rajdeepsaha2003/ProstheticHand1/Candy/graphics/board/back.png

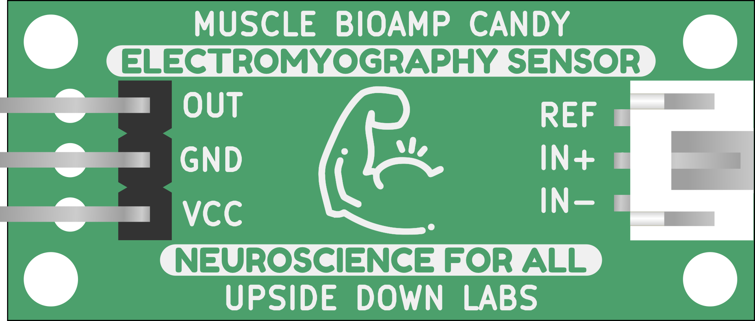
Candy/graphics/board/back.png
