rajdeepsaha2003/ProstheticHand1/Candy/graphics/board/dimensions.png

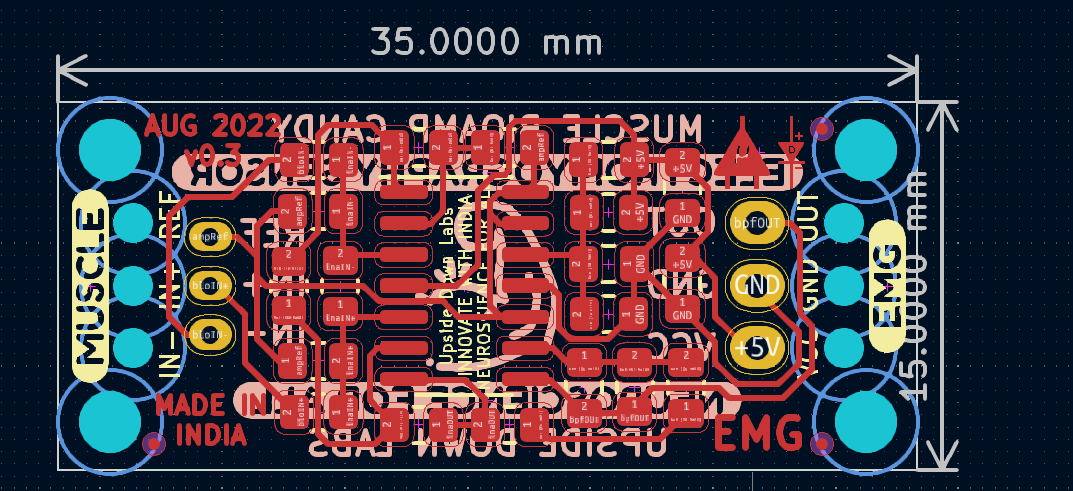
Candy/graphics/board/dimensions.png
