rajdeepsaha2003/ProstheticHand1/Candy/graphics/board/front.png

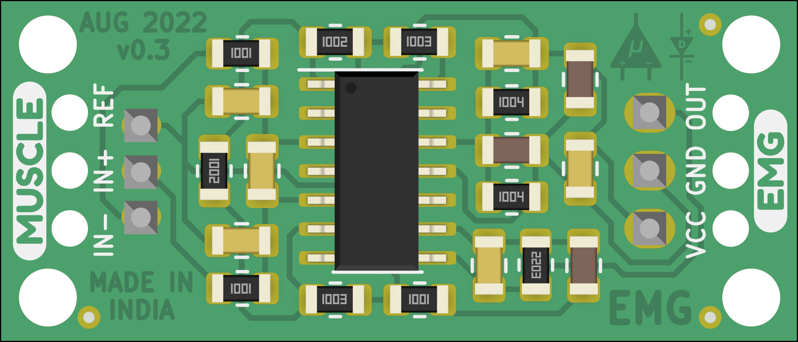
Candy/graphics/board/front.png
