rajdeepsaha2003/ProstheticHand1/Candy/graphics/board/PCBback.png

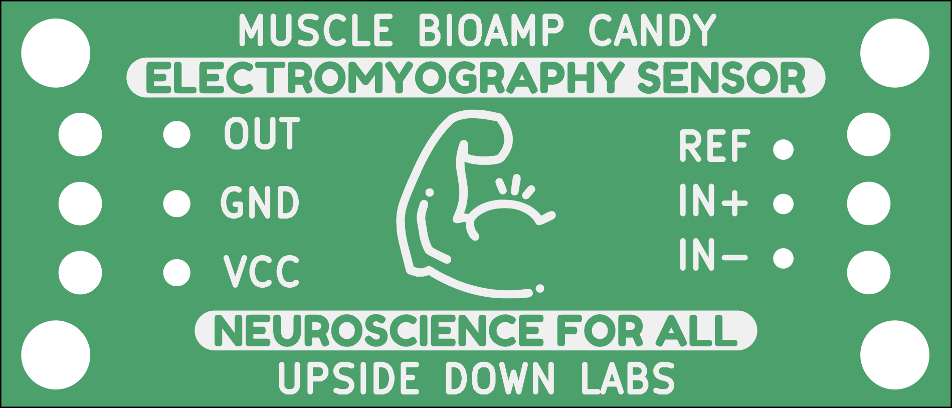
Candy/graphics/board/PCBback.png
