rajdeepsaha2003/ProstheticHand1/Candy/graphics/board/PCBfront.png

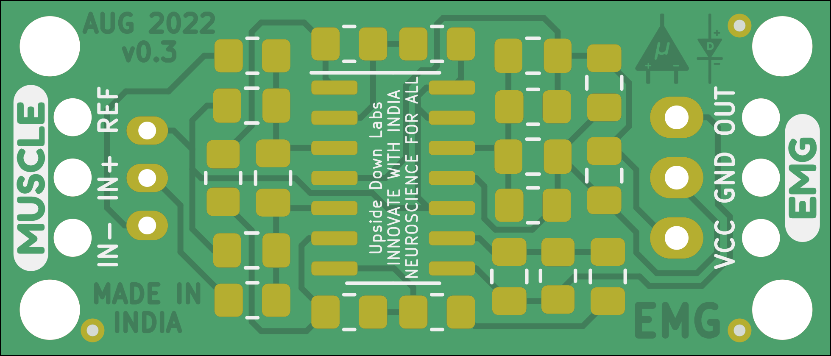
Candy/graphics/board/PCBfront.png
