rajdeepsaha2003/ProstheticHand1/Candy/graphics/ElectrodePlacementExample.png

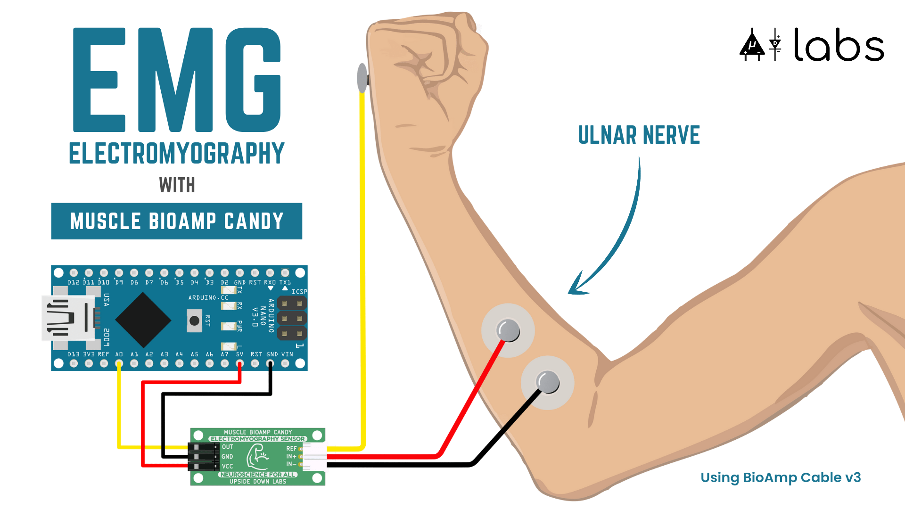
Candy/graphics/ElectrodePlacementExample.png
