rajdeepsaha2003/ProstheticHand1/media/image1.jpg

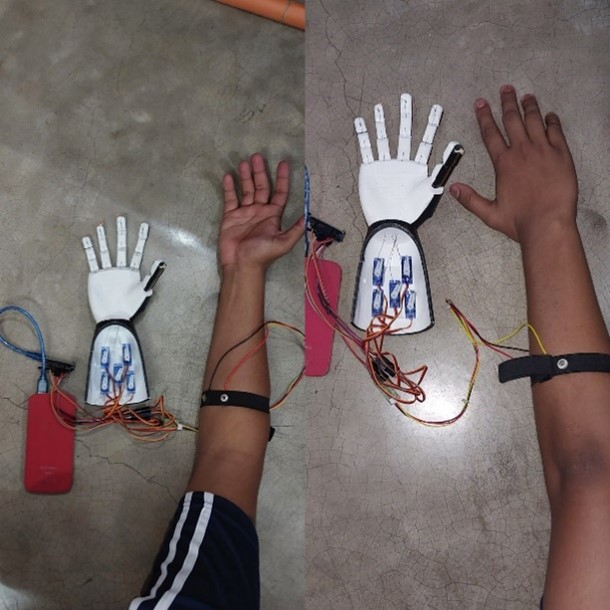
media/image1.jpg
