rajdeepsaha2003/ProstheticHand1/media/image14.jpg

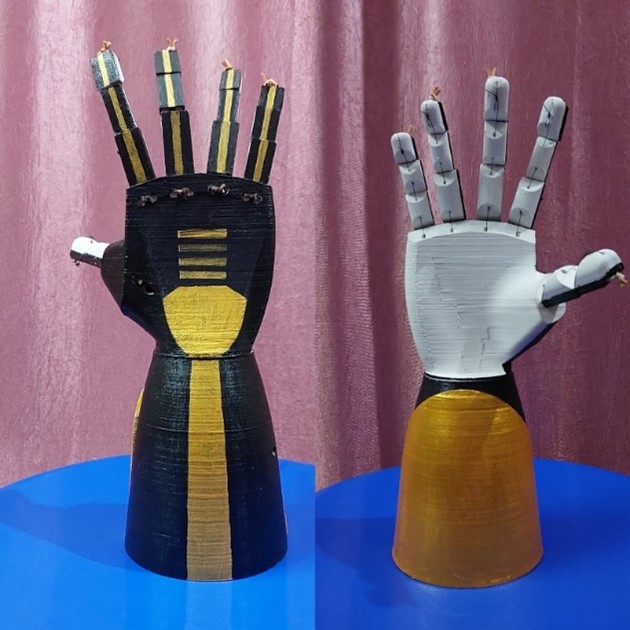
media/image14.jpg
