rajdeepsaha2003/ProstheticHand1/media/image19.png

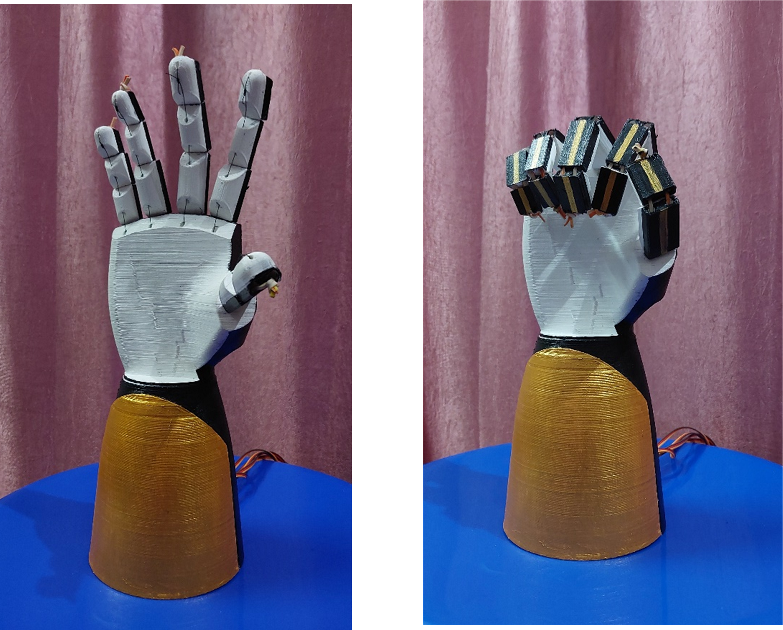
media/image19.png
