rajdeepsaha2003/ProstheticHand1/media/image21.jpg

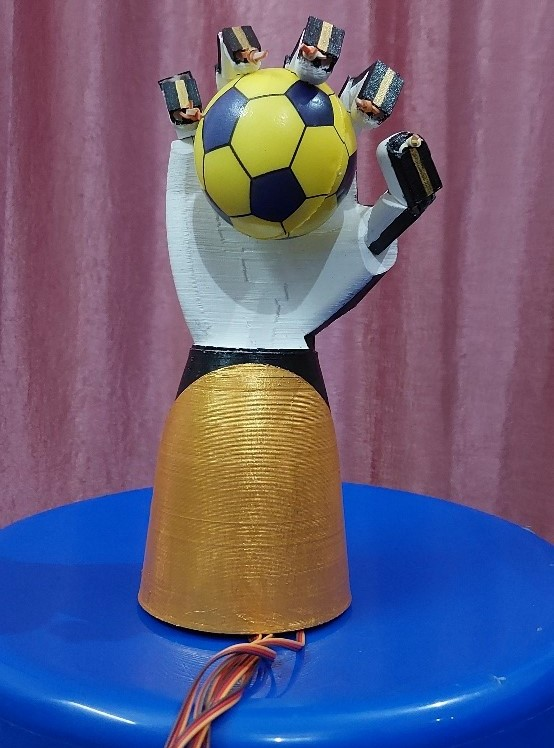
media/image21.jpg
