rajdeepsaha2003/ProstheticHand1/media/image22.jpg

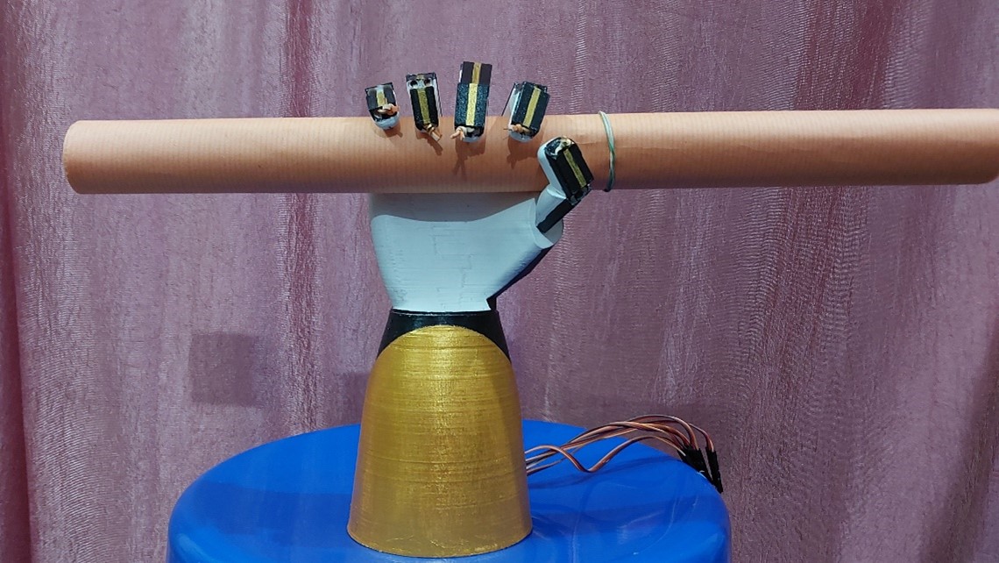
media/image22.jpg
