rajdeepsaha2003/ProstheticHand1/media/Screenshot 2024-03-30 111446.png

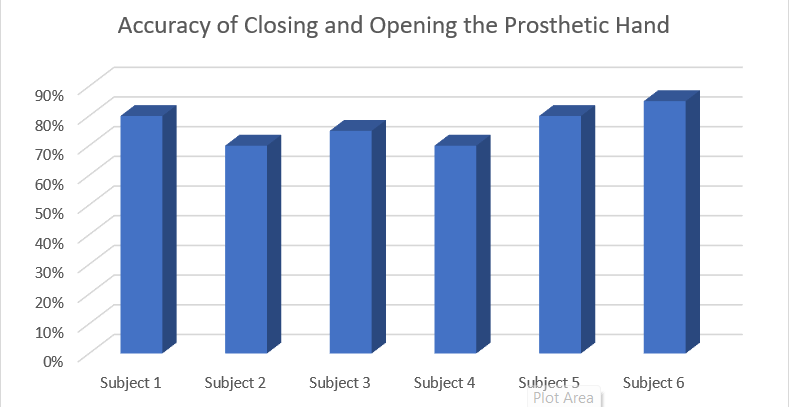
media/Screenshot 2024-03-30 111446.png
