rajdeepsaha2003/ProstheticHand1/Prosthetic_hand/3D Files Robo Hand/Screenshot 2024-03-03 145712.png

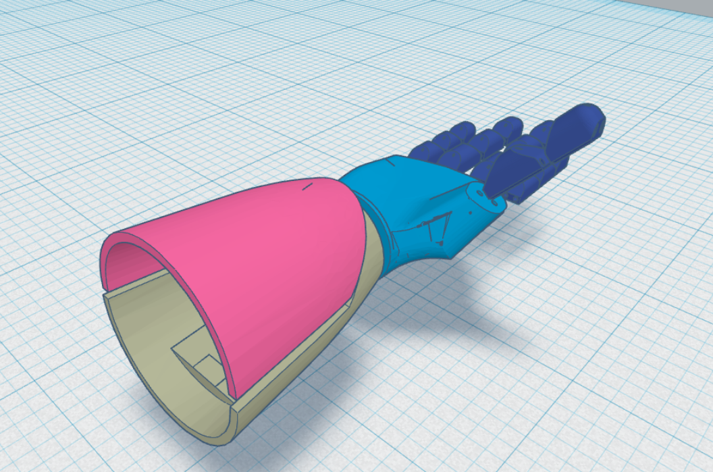
Prosthetic_hand/3D Files Robo Hand/Screenshot 2024-03-03 145712.png
