rajdeepsaha2003/ProstheticHand1/Prosthetic_hand/3D-Claw/Servo gripper v8.png

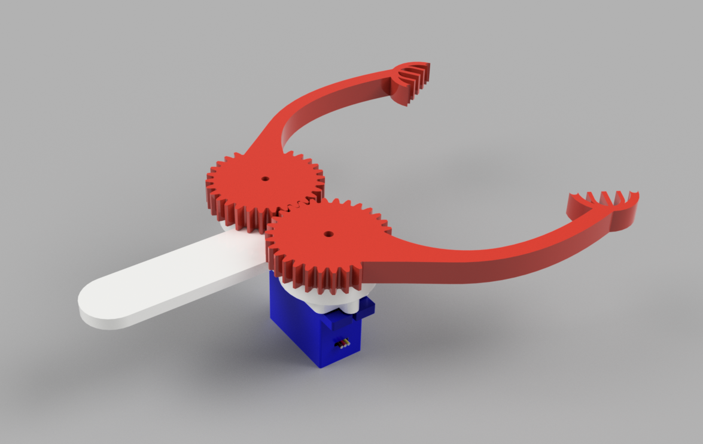
Prosthetic_hand/3D-Claw/Servo gripper v8.png
