rajdeepsaha2003/ProstheticHand1/data.xlsx

Sheet: Data In
Data In (From USB Serial Device (COM8))
Data coming from the current data source will appear below as it is received.
Current Data
TIME | CH1 | CH2 | CH3 | CH4 | CH5 | CH6 | CH7 | CH8 | CH9 | CH10
10:19:45 | -74 | 60 | 69
Historical Data
TIME | CH1 | CH2 | CH3 | CH4 | CH5 | CH6 | CH7 | CH8 | CH9 | CH10
10:19:45 | -89 | 60 | 101
10:19:45 | 83 | 60 | 8
10:19:45 | 42 | 60 | 65
10:19:45 | -4 | 60 | 101
10:19:45 | -9 | 60 | 66
10:19:45 | -59 | 60 | 86
10:19:45 | -86 | 60 | 51
10:19:45 | 31 | 60 | 2
10:19:45 | 81 | 60 | 14
10:19:45 | -18 | 60 | 22
10:19:45 | -25 | 60 | 1
10:19:45 | -75 | 60 | 0
10:19:45 | -74 | 60 | 69
10:19:45 | -99 | 60 | 7
10:19:45 | -108 | 60 | 101

Sheet: Data Out
Data Out (To Device)
Data entered into the channels below will be sent to the currently connected device as a comma-delimited string.
CH1 | CH2 | CH3 | CH4 | CH5 | CH6 | CH7 | CH8 | CH9 | CH10

Sheet: Settings
Workbook Settings
Settings below will affect how data is read into the current workbook from data sources. Clear a field's contents to revert to its default setting.
Data interval (ms) | 150 | 150
Data rows | 15 | 15
Data channels | 10 | 10
Data orientation | Newest last | Newest last
WARNING: Changing settings may result in the loss of content and/or custom formatting in the Data In and Data Out worksheets. Always save before changing values.

Sheet: Manifest
USB Serial Device |  |  |  |  |  |  |  |  | {"Channels":[{"Description":null,"Id":null,"IsGhost":false,"Name":null,"Status":"Active","SubChannels":[{"Description":null,"Id":"CH1","IsGhost":false,"Name":"CH1","Status":"Active","SubChannels":[],"UnitOfMeasure":null},{"Description":null,"Id":"CH2","IsGhost":false,"Name":"CH2","Status":"Active","SubChannels":[],"UnitOfMeasure":null},{"Description":null,"Id":"CH3","IsGhost":false,"Name":"CH3","Status":"Active","SubChannels":[],"UnitOfMeasure":null},{"Description":null,"Id":"CH4","IsGhost":false,"Name":"CH4","Status":"Active","SubChannels":[],"UnitOfMeasure":null},{"Description":null,"Id":"CH5","IsGhost":false,"Name":"CH5","Status":"Active","SubChannels":[],"UnitOfMeasure":null},{"Description":null,"Id":"CH6","IsGhost":false,"Name":"CH6","Status":"Active","SubChannels":[],"UnitOfMeasure":null},{"Description":null,"Id":"CH7","IsGhost":false,"Name":"CH7","Status":"Active","SubChannels":[],"UnitOfMeasure":null},{"Description":null,"Id":"CH8","IsGhost":false,"Name":"CH8","Status":"Active","SubChannels":[],"UnitOfMeasure":null},{"Description":null,"Id":"CH9","IsGhost":false,"Name":"CH9","Status":"Active","SubChannels":[],"UnitOfMeasure":null},{"Description":null,"Id":"CH10","IsGhost":false,"Name":"CH10","Status":"Active","SubChannels":[],"UnitOfMeasure":null}],"UnitOfMeasure":null}],"Commands":[],"DataInterval":150,"Id":"AA923046-192F-4F57-BC0B-B5F319ADB549","IsGenerated":true,"Name":"USB Serial Device","Version":null,"BaudRate":115200}
This manifest was generated for the connected device. You can edit the device name and channel data here and the Data In worksheet will be updated.
 | Channels
 |  |  |  |  |  |  | Data Source Id
 |  | Id | Name | Description | Unit of Measure | Active | AA923046-192F-4F57-BC0B-B5F319ADB549 | 1
 |  | CH1 | CH1 |  |  | ü | Data Interval (ms)
 |  | CH2 | CH2 |  |  | ü | 150
 |  | CH3 | CH3 |  |  | ü | Baud Rate
 |  | CH4 | CH4 |  |  | ü | 115200
 |  | CH5 | CH5 |  |  | ü
 |  | CH6 | CH6 |  |  | ü
 |  | CH7 | CH7 |  |  | ü
 |  | CH8 | CH8 |  |  | ü
 |  | CH9 | CH9 |  |  | ü
 |  | CH10 | CH10 |  |  | ü
