rajdeepsaha2003/ProstheticHand1/Prosthetic_hand/3D Files Robo Hand/Arm_Cover.stl

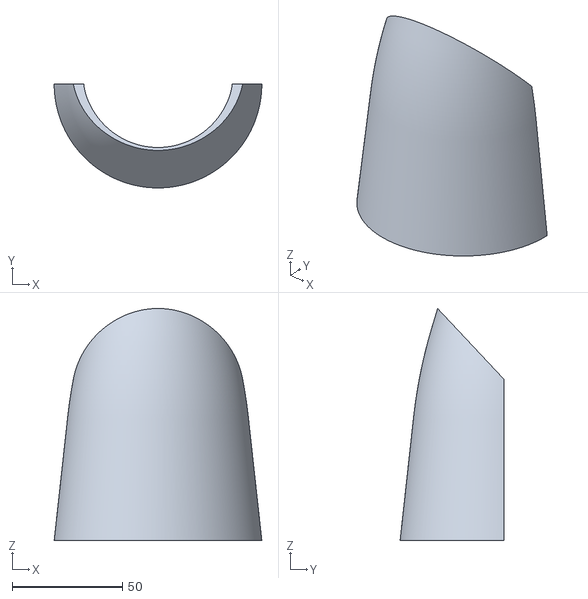
[picture p32: CAD file, 2024-03-30]
Prosthetic_hand/3D Files Robo Hand/Arm_Cover.stl
94.0 x 47.0 x 105.0
