rajdeepsaha2003/ProstheticHand1/Prosthetic_hand/3D-Claw/Base.stl

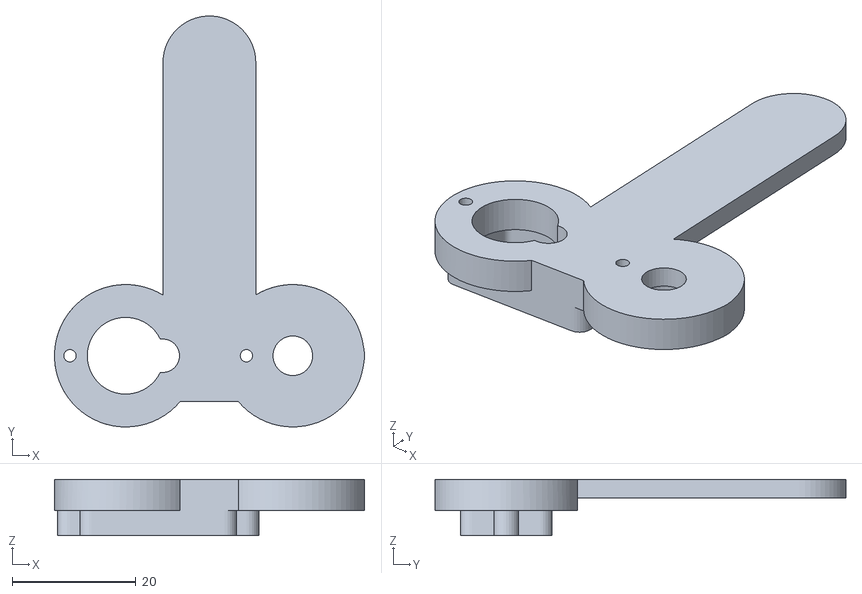
[picture p33: CAD file, 2024-03-30]
Prosthetic_hand/3D-Claw/Base.stl
50.1 x 66.4 x 9.10
