rajdeepsaha2003/ProstheticHand1/Prosthetic_hand/3D Files Robo Hand/Finger_Thumb.stl

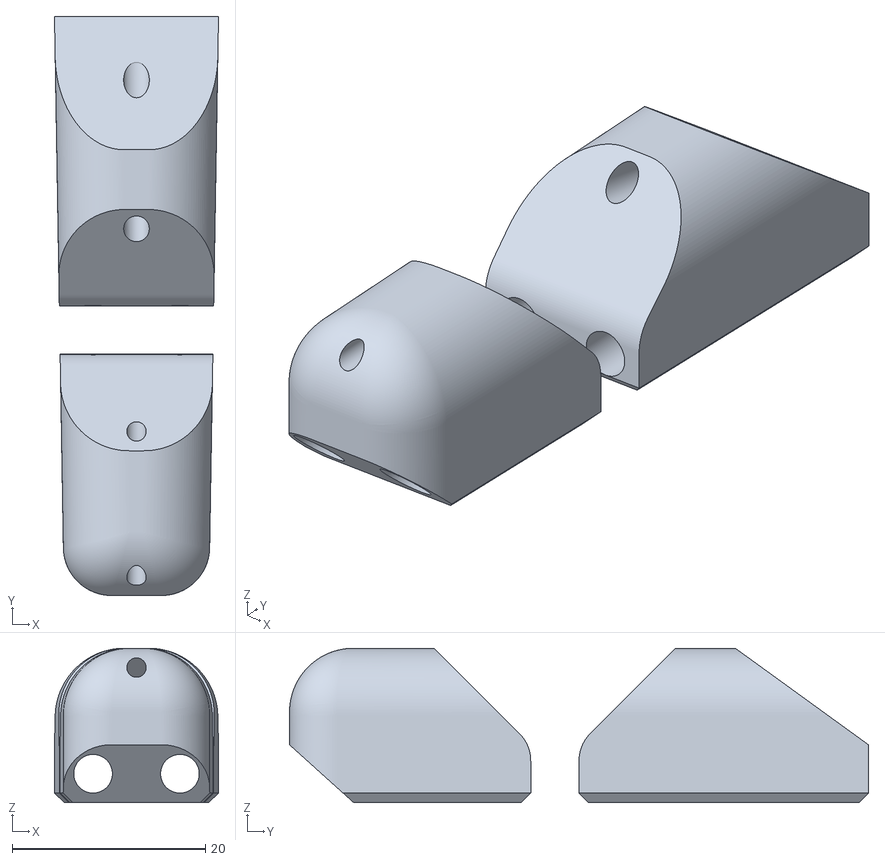
[picture p34: CAD file, 2024-03-30]
Prosthetic_hand/3D Files Robo Hand/Finger_Thumb.stl
17.0 x 60.0 x 16.0
