rajdeepsaha2003/ProstheticHand1/Prosthetic_hand/3D-Claw/arm 1.stl

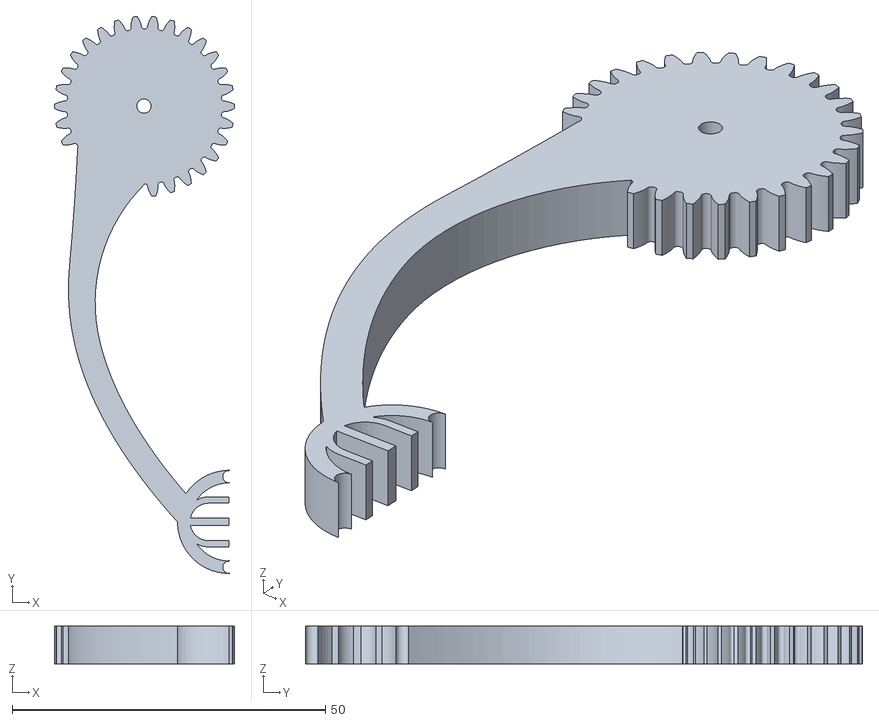
[picture p35: CAD file, 2024-03-30]
Prosthetic_hand/3D-Claw/arm 1.stl
28.8 x 88.9 x 6.00
