rajdeepsaha2003/ProstheticHand1/Prosthetic_hand/3D Files Robo Hand/Finger_Middle.stl

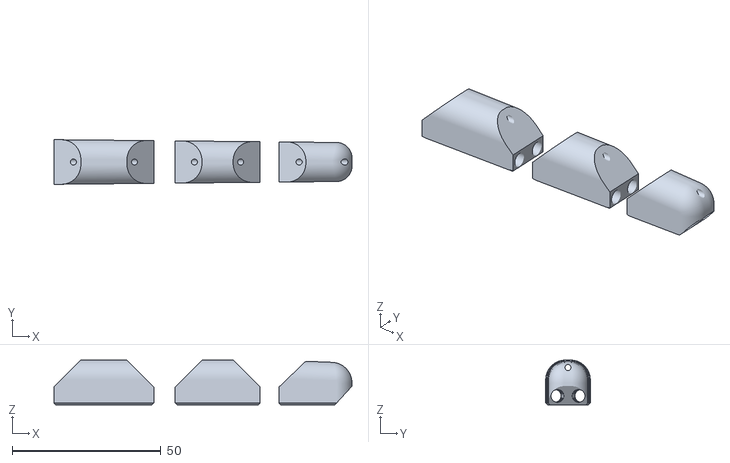
[picture p36: CAD file, 2024-03-30]
Prosthetic_hand/3D Files Robo Hand/Finger_Middle.stl
100.0 x 15.0 x 15.0
