rajdeepsaha2003/ProstheticHand1/Prosthetic_hand/3D-Claw/arm 2.stl

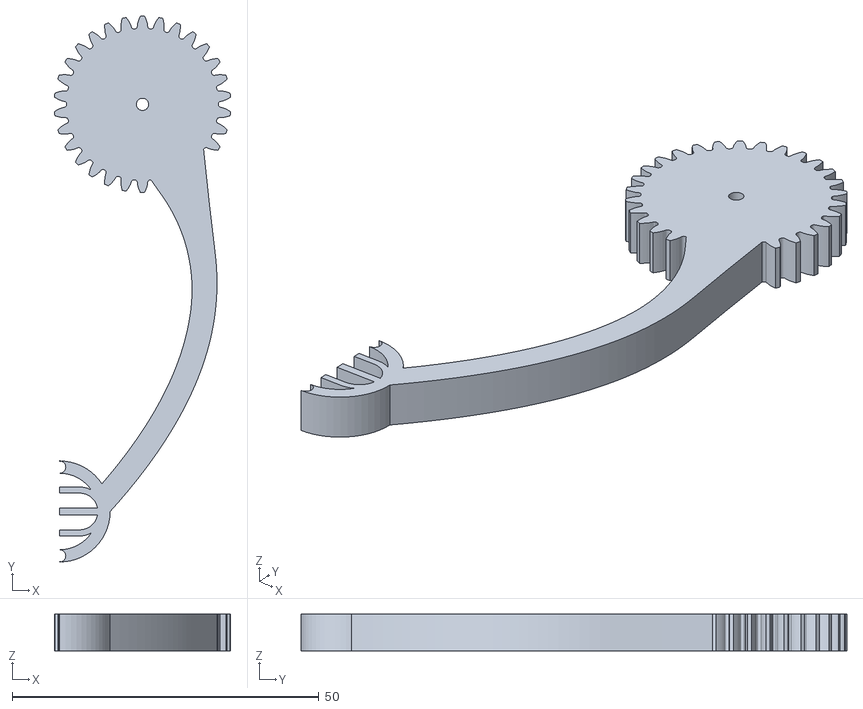
[picture p37: CAD file, 2024-03-30]
Prosthetic_hand/3D-Claw/arm 2.stl
28.7 x 89.0 x 6.00
