rajdeepsaha2003/ProstheticHand1/Prosthetic_hand/3D Files Robo Hand/Finger_Pinky.stl

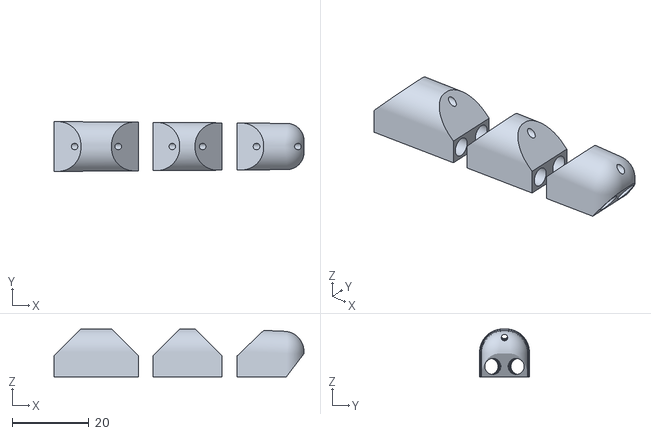
[picture p38: CAD file, 2024-03-30]
Prosthetic_hand/3D Files Robo Hand/Finger_Pinky.stl
65.2 x 13.0 x 12.5
