rajdeepsaha2003/ProstheticHand1/Prosthetic_hand/3D-Claw/gear connector.stl

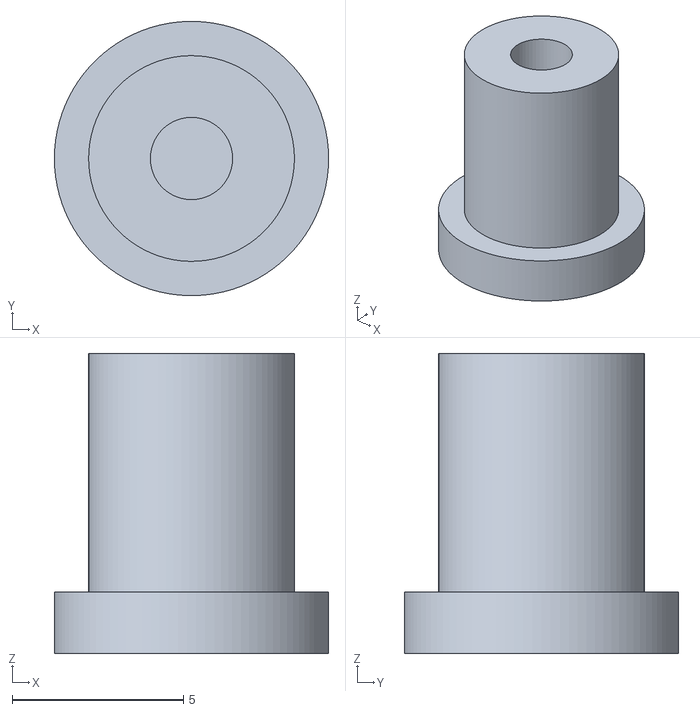
[picture p39: CAD file, 2024-03-30]
Prosthetic_hand/3D-Claw/gear connector.stl
8.00 x 8.00 x 8.75
