rajdeepsaha2003/ProstheticHand1/Prosthetic_hand/3D Files Robo Hand/Finger_Index.stl

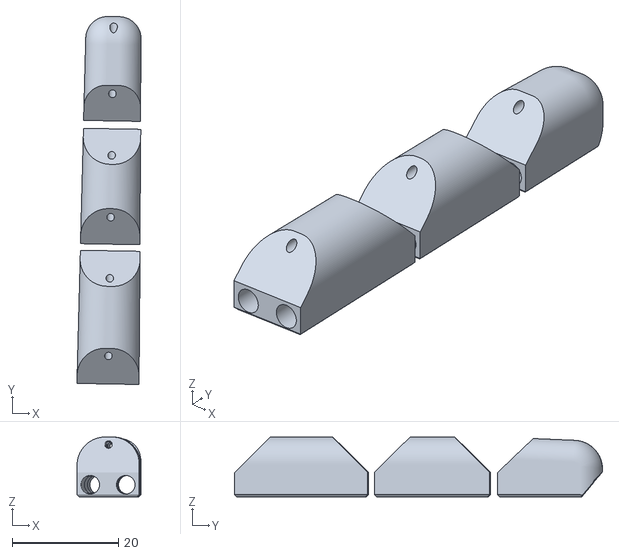
[picture p40: CAD file, 2024-03-30]
Prosthetic_hand/3D Files Robo Hand/Finger_Index.stl
12.1 x 69.4 x 11.3
