rajdeepsaha2003/ProstheticHand1/Prosthetic_hand/3D Files Robo Hand/Arm.stl

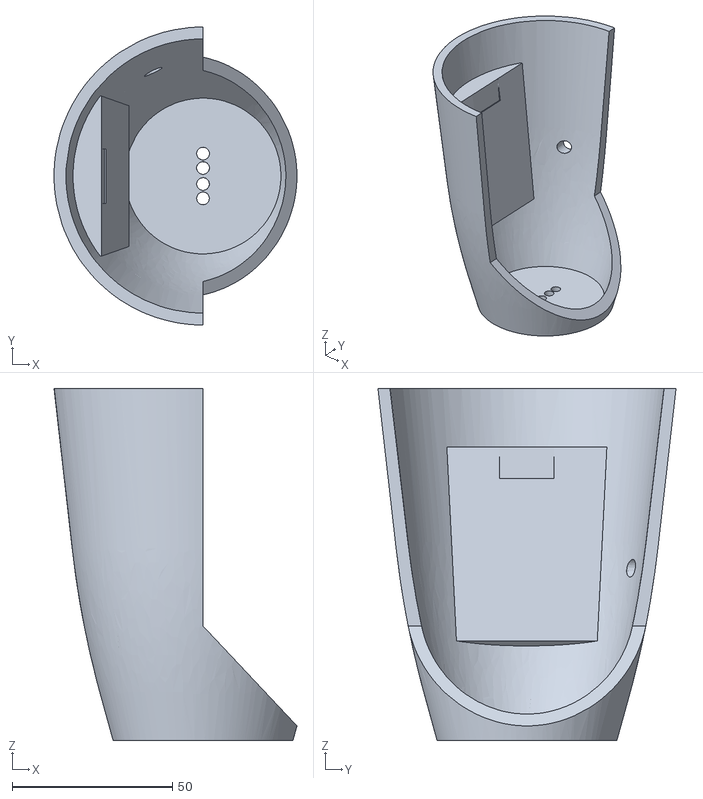
[picture p41: CAD file, 2024-03-30]
Prosthetic_hand/3D Files Robo Hand/Arm.stl
75.9 x 93.1 x 109.9
