rajdeepsaha2003/ProstheticHand1/Prosthetic_hand/3D Files Robo Hand/Finger_Ring.stl

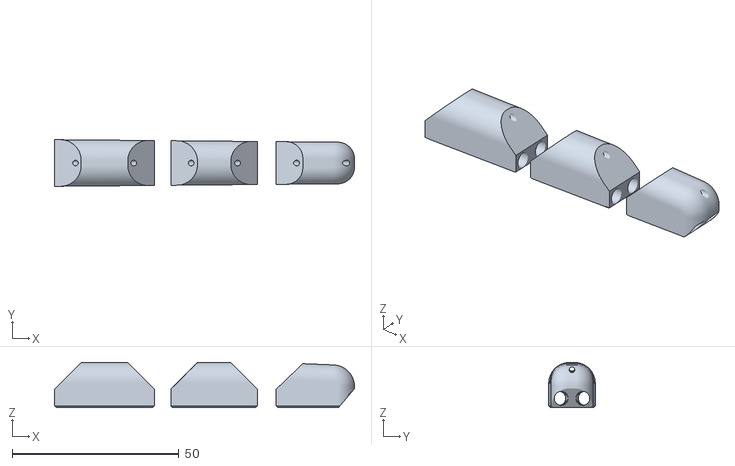
[picture p42: CAD file, 2024-03-30]
Prosthetic_hand/3D Files Robo Hand/Finger_Ring.stl
90.0 x 14.0 x 13.5
