rajdeepsaha2003/ProstheticHand1/Candy/hardware/EMG-Candy.kicad_pcb

## KiCad design Candy/hardware/EMG-Candy.kicad_pcb (2024-03-30)

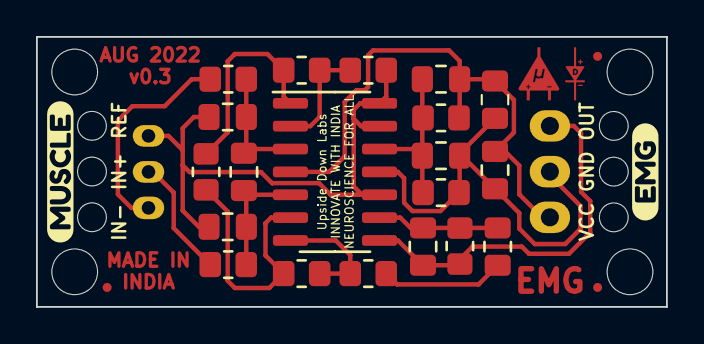
[picture p43: board EMG-Candy.kicad_pcb from above]

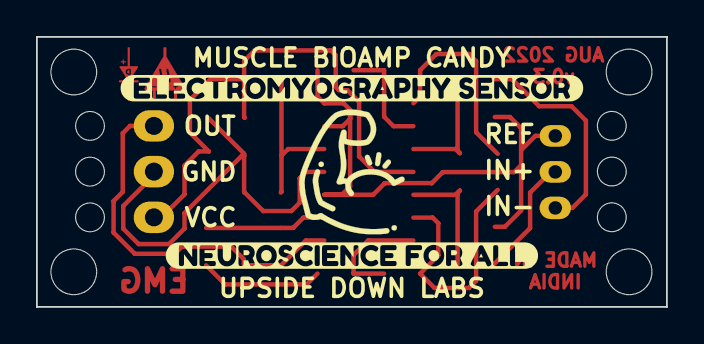
[picture p44: board EMG-Candy.kicad_pcb from below]

Board: 2 copper layers, 35.0 x 15.0 mm, 39 parts (4 on the bottom side), 13 nets.

Parts:
C1, C3: 100pF; C_0805_2012Metric_Pad1.18x1.45mm_HandSolder
C2, C7: 1nF; C_0805_2012Metric_Pad1.18x1.45mm_HandSolder
C4, C8: 100nF; C_0805_2012Metric_Pad1.18x1.45mm_HandSolder
C5, C6: 2.2uF; C_0805_2012Metric_Pad1.18x1.45mm_HandSolder
C9: 47uF; C_0805_2012Metric_Pad1.18x1.45mm_HandSolder
F1**, F2**, F3**: Fiducial_0.5mm_Mask1mm
H1, H2, H3, H4, H5, H6, H7, H8, H9, H10: MountingHole; MountingHole_2.1mm
J1: IO; PinHeader_1x03_P2.54mm_Horizontal
J3: BioAmp_input; JST_PH_S3B-PH-K_1x03_P2.00mm_Horizontal
R1, R2: 1K; R_0805_2012Metric_Pad1.20x1.40mm_HandSolder
R3, R4: 1M; R_0805_2012Metric_Pad1.20x1.40mm_HandSolder
R5: 1k; R_0805_2012Metric_Pad1.20x1.40mm_HandSolder
R6: 220K; R_0805_2012Metric_Pad1.20x1.40mm_HandSolder
R7, R10: 100k; R_0805_2012Metric_Pad1.20x1.40mm_HandSolder
R8, R9: 10k; R_0805_2012Metric_Pad1.20x1.40mm_HandSolder
U1: Amp; SOIC-14_3.9x8.7mm_P1.27mm
kibuzzard-62E8CB67: G***; kibuzzard-62E8CB67
kibuzzard-626BB171: G***; kibuzzard-626BB171
kibuzzard-626FA17E: G***; kibuzzard-626FA17E
kibuzzard-626FA157: G***; kibuzzard-626FA157

Connections:
+5V: C4.2, C8.2, C9.2, R3.2, U1.4 (V+)
GND: C5.1, C8.1, C9.1, R4.1, U1.11 (V-)
unnamed: C4.1, C5.2, R3.1, R4.2, U1.12 (+)
unnamed: C6.1, R5.1
unnamed: C6.2, C7.1, R6.2, U1.9 (-)
unnamed: R7.1, R8.2, U1.2 (-)
unnamed: R8.1, R9.2, U1.1
unnamed: R9.1, R10.2, U1.6 (-)
ampRef: C1.2, C3.1, R7.2, U1.10 (+), U1.13 (-), U1.14
bpfOUT: C7.2, R6.1, U1.8
inaIN+: C2.1, C3.2, R2.1, U1.5 (+)
inaIN-: C1.1, C2.2, R1.1, U1.3 (+)
inaOUT: R5.2, R10.1, U1.7
