rajdeepsaha2003/ProstheticHand1/Prosthetic_hand/Prosthetic_hand.ino

// Claw Controller - BioAmp EXG Pill
// Use for Bionic (wolverine) claw as well
// https://github.com/upsidedownlabs/BioAmp-EXG-Pill

// Upside Down Labs invests time and resources providing this open source code,
// please support Upside Down Labs and open-source hardware by purchasing
// products from Upside Down Labs!

// Copyright (c) 2021 - 2023 Upside Down Labs - contact@upsidedownlabs.tech

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
#if defined(ESP32) 
  // For ESP32 Servo library
  #include <ESP32Servo.h>
#else
  // Arduino Servo library
  #include <Servo.h>
#endif

// Samples per second
#define SAMPLE_RATE 500

// Make sure to set the same baud rate on your Serial Monitor/Plotter
#define BAUD_RATE 115200

// Change if not using A0 analog pin
#define INPUT_PIN A0

// envelopeee buffer size
// High value -> smooth but less responsive
// Low value -> not smooth but responsive
#define BUFFER_SIZE 64

// Initializing 5 servo fingers
Servo thumb;
Servo index;
Servo midd;
Servo ring;
Servo pinky;

// Servo pin (Change as per your connection)
#define THUMB_PIN 2 
#define INDEX_PIN 3
#define MIDD_PIN 5
#define RING_PIN 6
#define PINKY_PIN 4

// Pin for writing
#define writePin 10
#define writeEN 11

// EMG Threshold value, different for each user
// Check by plotting EMG envelopee data on Serial plotter
#define EMG_THRESHOLD 60

// Servo open & close angles
#define SERVO_OPEN 0
#define SERVO_CLOSE 180

// EMG Envelope baseline value
// Minimum value without flexing hand
#define EMG_ENVELOPE_BASELINE 4

// EMG Envelope divider
// Minimum value increase required to turn on a single LED
#define EMG_ENVELOPE_DIVIDER 4


Servo servo;
// Servo toggle flag
bool flag = 0;
// Last gesture timestamp
unsigned long lastGestureTime = 0;
// Delay between two actions
unsigned long gestureDelay = 240;

int circular_buffer[BUFFER_SIZE];
int data_index, sum;

// Muscle BioAmp Shield v0.3 LED pin numbers in-order
// int led_bar[] = {8, 9, 10, 11, 12, 13};
// int total_leds = sizeof(led_bar) / sizeof(led_bar[0]);

void setup() {
  // Serial connection begin
  Serial.begin(BAUD_RATE);
  // Initialize all the led_bar
    // for (int i = 0; i < total_leds; i++) {
    //   pinMode(led_bar[i], OUTPUT);
    // }
    pinMode(writePin,INPUT);
    pinMode(writeEN,INPUT);
 
   thumb.attach(THUMB_PIN);
   thumb.write(0);
   index.attach(INDEX_PIN);
   index.write(0);
   midd.attach(MIDD_PIN);
   midd.write(0);
   ring.attach(RING_PIN);
   ring.write(0);
   pinky.attach(PINKY_PIN);
   pinky.write(0);
}

void loop() {
  // Calculate elapsed time
  static unsigned long past = 0;
  unsigned long present = micros();
  unsigned long interval = present - past;
  past = present;

  // Run timer
  static long timer = 0;
  timer -= interval;

  // Sample and get envelope
  if(timer < 0) {
    timer += 1000000 / SAMPLE_RATE;
   
    // RAW EMG Values
    int sensor_value = analogRead(INPUT_PIN);
    
    // Filtered EMG
    int signal = EMGFilter(sensor_value);
    
    // EMG envelopee
    int envelope = getEnvelope(abs(signal));


    int writePin_value=digitalRead(writePin);
    int write_value=digitalRead(writeEN); 
    
      
    
    
      if(envelope > EMG_THRESHOLD) {
        if((millis() - lastGestureTime) > gestureDelay){
        if(flag == 1){
          ring.write(0);
          thumb.write(0);
          index.write(0);
          midd.write(0);
          pinky.write(0);
          
          flag = 0;
          lastGestureTime = millis();
          delay(100);
        }
        else {
          // Close all servos
          ring.write(180);
          thumb.write(180);
          index.write(180);
          midd.write(180);
          pinky.write(180);
          flag = 1;
          lastGestureTime = millis();
          delay(100);
        }
        }
      } 
    
    
    
    Serial.print(signal);
    Serial.print(",");
    Serial.println(envelope);
    // Serial.print(",");
    // Serial.println(EMG_THRESHOLD);
    // Serial.print("\n ");

  }
}

// envelope detection algorithm
int getEnvelope(int abs_emg){
  sum -= circular_buffer[data_index];
  sum += abs_emg;
  circular_buffer[data_index] = abs_emg;
  data_index = (data_index + 1) % BUFFER_SIZE;
  return (sum/BUFFER_SIZE) * 2;
}

// Band-Pass Butterworth IIR digital filter, generated using filter_gen.py.
// Sampling rate: 500.0 Hz, frequency: [74.5, 149.5] Hz.
// Filter is order 4, implemented as second-order sections (biquads).
// Reference: 
// https://docs.scipy.org/doc/scipy/reference/generated/scipy.signal.butter.html
// https://courses.ideate.cmu.edu/16-223/f2020/Arduino/FilterDemos/filter_gen.py
float EMGFilter(float input)
{
  float output = input;
  {
    static float z1, z2; // filter section state
    float x = output - 0.05159732*z1 - 0.36347401*z2;
    output = 0.01856301*x + 0.03712602*z1 + 0.01856301*z2;
    z2 = z1;
    z1 = x;
  }
  {
    static float z1, z2; // filter section state
    float x = output - -0.53945795*z1 - 0.39764934*z2;
    output = 1.00000000*x + -2.00000000*z1 + 1.00000000*z2;
    z2 = z1;
    z1 = x;
  }
  {
    static float z1, z2; // filter section state
    float x = output - 0.47319594*z1 - 0.70744137*z2;
    output = 1.00000000*x + 2.00000000*z1 + 1.00000000*z2;
    z2 = z1;
    z1 = x;
  }
  {
    static float z1, z2; // filter section state
    float x = output - -1.00211112*z1 - 0.74520226*z2;
    output = 1.00000000*x + -2.00000000*z1 + 1.00000000*z2;
    z2 = z1;
    z1 = x;
  }
  return output;
}
